kumencz/ROwen/PCB/render_2.png

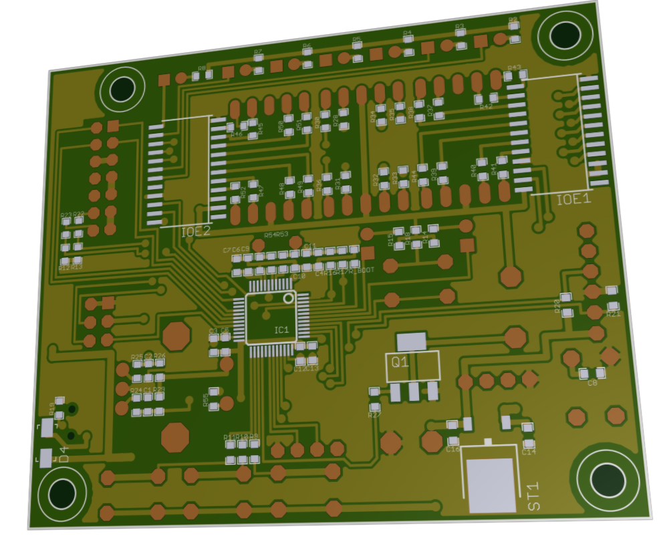
PCB/render_2.png
