kumencz/ROwen/README.md

# Reflow Owen
Reflow soldering heater project for FEKT VUT Brno
