kumencz/ROwen/PCB/render_1.png

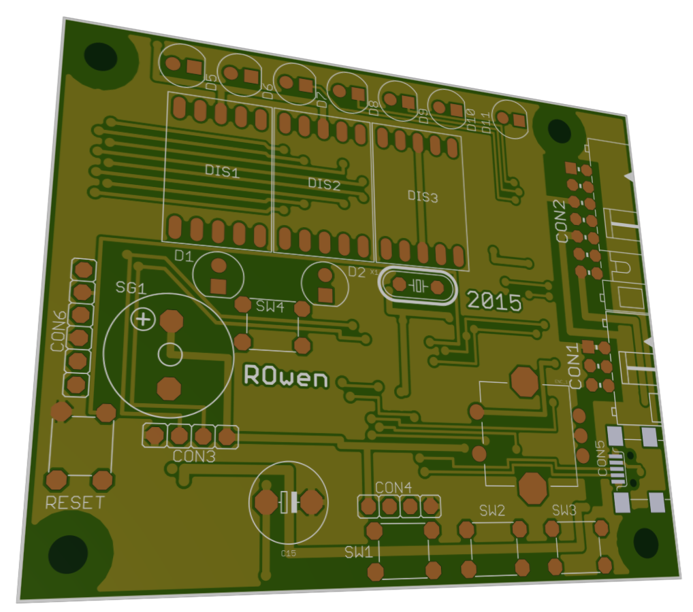
PCB/render_1.png
