kumencz/ROwen/Case/logic_board_case_rev1.stl

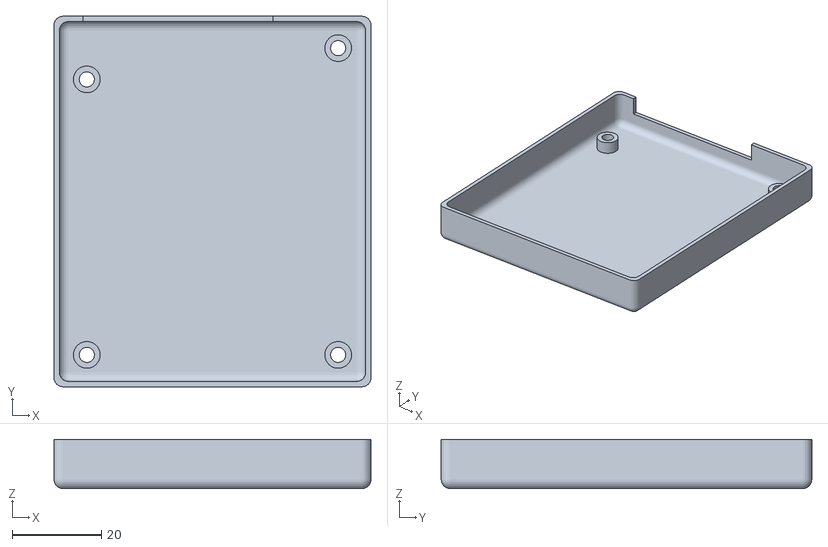
[picture p3: CAD file, 2020-12-23]
Case/logic_board_case_rev1.stl
71.0 x 83.0 x 11.0
