kumencz/ROwen/Case/logic_board_case_top_rev1.stl

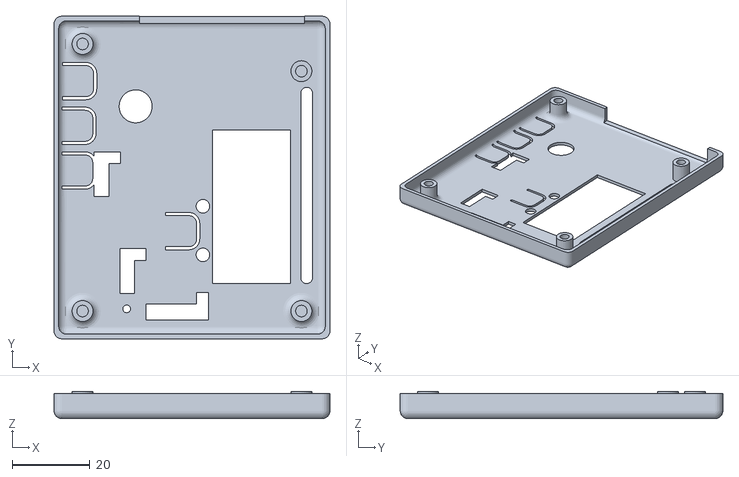
[picture p4: CAD file, 2020-12-23]
Case/logic_board_case_top_rev1.stl
71.0 x 83.0 x 7.00
