kumencz/ROwen/PCB/ROwen_main.brd

## EAGLE design PCB/ROwen_main.brd (2015-04-16)

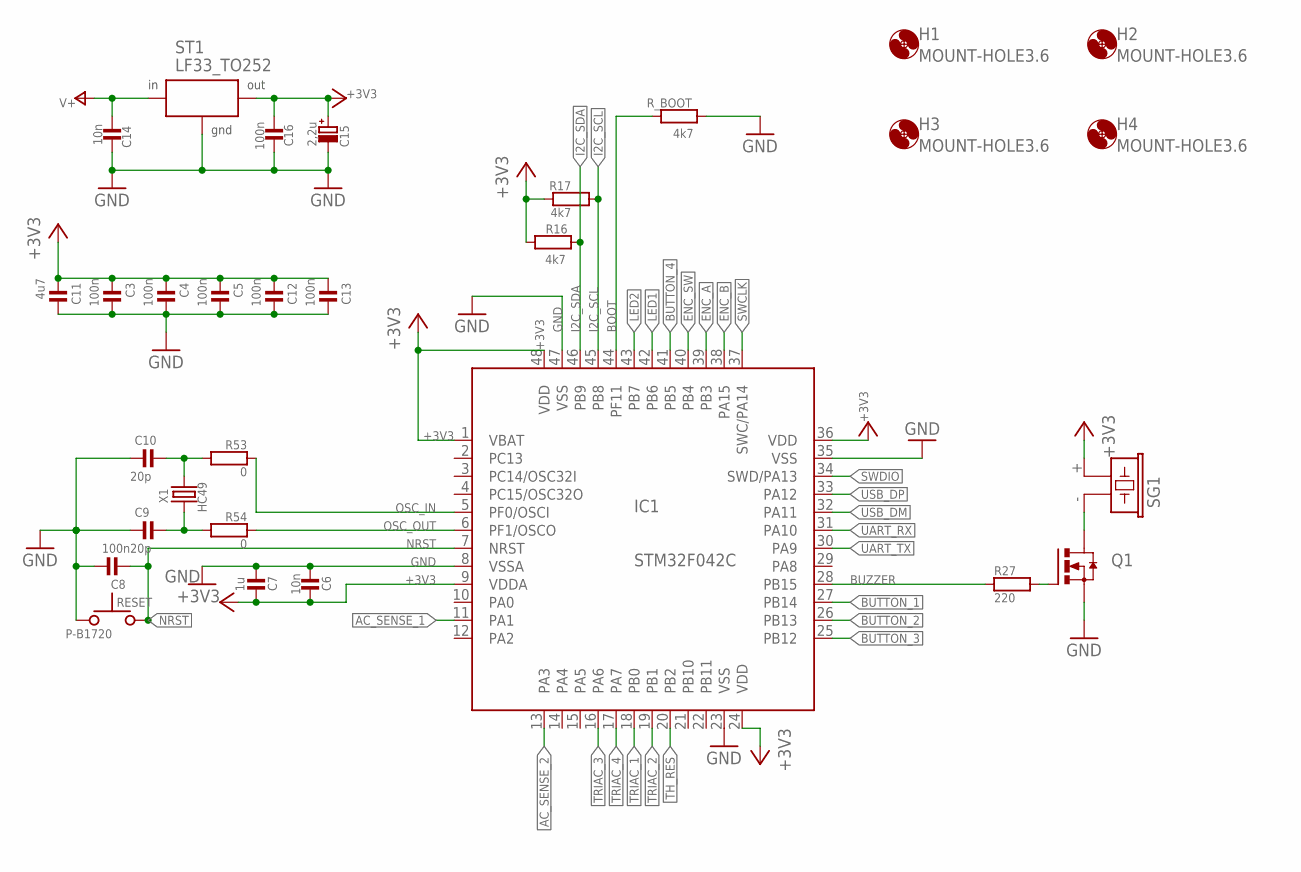
[picture p5: schematic ROwen_main.sch, sheet 1]

Parts:
C3, C4, C5, C8, C12, C13, C16: 100n; 0603
C6, C14: 10n; 0603
C7: 1u; 0603
C9, C10: 20p; 0603
C11: 4u7; 0603
C15: 2,2u; ER_08,5_05
H1, H2, H3, H4: MOUNT-HOLE3.6; 3,6
IC1: STM32F042C; LQFP48
Q1: N-HEXFET-2D_SOT232-IRLL014N; SOT223
R16, R17: 4k7; 0603
R27: 220; 0603
R53, R54: 0; 0603
RESET: P-B1720
R_BOOT: 4k7; 0603
SG1: F/CM12P
ST1: LF33_TO252; DPACK
X1: HC49; X_HC49/S

Connections:
+3V3: C3.2, C4.2, C5.2, C6.1, C7.1, C11.2, C12.2, C13.2, C15.+, C16.2, IC1.1 (VBAT), IC1.9 (VDDA), IC1.24 (VDD), IC1.36 (VDD), IC1.48 (VDD), R16.2, R17.2, SG1.+ (1), ST1.3 (OUT); also elsewhere on the board
AC_SENSE_1: IC1.11 (PA1); also elsewhere on the board
AC_SENSE_2: IC1.13 (PA3); also elsewhere on the board
BOOT: IC1.44 (PF11), R_BOOT.2
BUTTON_1: IC1.27 (PB14); also elsewhere on the board
BUTTON_2: IC1.26 (PB13); also elsewhere on the board
BUTTON_3: IC1.25 (PB12); also elsewhere on the board
BUTTON_4: IC1.41 (PB5); also elsewhere on the board
BUZZER: IC1.28 (PB15), R27.1
ENC_A: IC1.39 (PB3); also elsewhere on the board
ENC_B: IC1.38 (PA15); also elsewhere on the board
ENC_SW: IC1.40 (PB4); also elsewhere on the board
GND: C3.1, C4.1, C5.1, C6.2, C7.2, C8.1, C9.2, C10.2, C11.1, C12.1, C13.1, C14.2, C15.-, C16.1, IC1.8 (VSSA), IC1.23 (VSS), IC1.35 (VSS), IC1.47 (VSS), Q1.3 (S), RESET.1, R_BOOT.1, ST1.2 (GND); also elsewhere on the board
I2C_SCL: IC1.45 (PB8), R17.1; also elsewhere on the board
I2C_SDA: IC1.46 (PB9), R16.1; also elsewhere on the board
LED1: IC1.42 (PB6); also elsewhere on the board
LED2: IC1.43 (PB7); also elsewhere on the board
unnamed: Q1.2 (D), Q1.4 (D), SG1.- (2)
unnamed: Q1.1 (G), R27.2
unnamed: C9.1, R54.2, X1.1
unnamed: C10.1, R53.2, X1.2
NRST: C8.2, IC1.7 (NRST), RESET.2; also elsewhere on the board
OSC_IN: IC1.5 (PF0/OSCI), R53.1
OSC_OUT: IC1.6 (PF1/OSCO), R54.1
SWCLK: IC1.37 (SWC/PA14); also elsewhere on the board
SWDIO: IC1.34 (SWD/PA13); also elsewhere on the board
TH_RES: IC1.20 (PB2); also elsewhere on the board
TRIAC_1: IC1.18 (PB0); also elsewhere on the board
TRIAC_2: IC1.19 (PB1); also elsewhere on the board
TRIAC_3: IC1.16 (PA6); also elsewhere on the board
TRIAC_4: IC1.17 (PA7); also elsewhere on the board
UART_RX: IC1.31 (PA10); also elsewhere on the board
UART_TX: IC1.30 (PA9); also elsewhere on the board
USB_DM: IC1.32 (PA11); also elsewhere on the board
USB_DP: IC1.33 (PA12); also elsewhere on the board
V+: C14.1, ST1.1 (IN); also elsewhere on the board

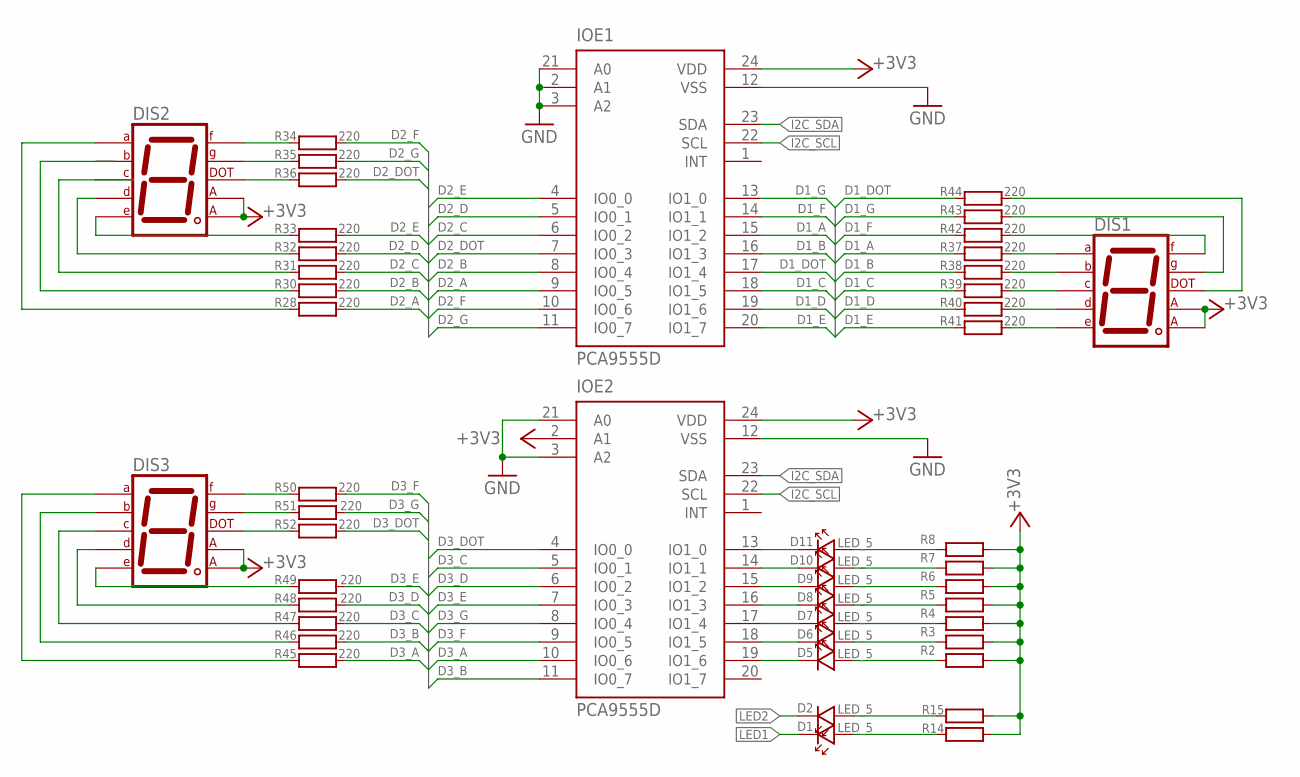
[picture p6: schematic ROwen_main.sch, sheet 2]

Parts:
D1, D2, D5, D6, D7, D8, D9, D10, D11: LED_5
DIS1, DIS2, DIS3: 7-SEGMENT-CA-0.56"; 7_SEGMENT_0.56"
IOE1, IOE2: PCA9555D; SO24
R2, R3, R4, R5, R6, R7, R8, R14, R15: R_R0603; 0603
R28, R30, R31, R32, R33, R34, R35, R36, R37, R38, R39, R40, R41, R42, R43, R44, R45, R46, R47, R48, R49, R50, R51, R52: 220; 0603

Connections:
+3V3: DIS1.3 (CA2), DIS1.8 (CA1), DIS2.3 (CA2), DIS2.8 (CA1), DIS3.3 (CA2), DIS3.8 (CA1), IOE1.24 (VDD), IOE2.2 (A1), IOE2.24 (VDD), R2.2, R3.2, R4.2, R5.2, R6.2, R7.2, R8.2, R14.2, R15.2; also elsewhere on the board
D1_A: IOE1.15 (IO1_2), R37.2
D1_B: IOE1.16 (IO1_3), R38.2
D1_C: IOE1.18 (IO1_5), R39.2
D1_D: IOE1.19 (IO1_6), R40.2
D1_DOT: IOE1.17 (IO1_4), R44.2
D1_E: IOE1.20 (IO1_7), R41.2
D1_F: IOE1.14 (IO1_1), R42.2
D1_G: IOE1.13 (IO1_0), R43.2
D2_A: IOE1.9 (IO0_5), R28.2
D2_B: IOE1.8 (IO0_4), R30.2
D2_C: IOE1.6 (IO0_2), R31.2
D2_D: IOE1.5 (IO0_1), R32.2
D2_DOT: IOE1.7 (IO0_3), R36.2
D2_E: IOE1.4 (IO0_0), R33.2
D2_F: IOE1.10 (IO0_6), R34.2
D2_G: IOE1.11 (IO0_7), R35.2
D3_A: IOE2.10 (IO0_6), R45.2
D3_B: IOE2.11 (IO0_7), R46.2
D3_C: IOE2.5 (IO0_1), R47.2
D3_D: IOE2.6 (IO0_2), R48.2
D3_DOT: IOE2.4 (IO0_0), R52.2
D3_E: IOE2.7 (IO0_3), R49.2
D3_F: IOE2.9 (IO0_5), R50.2
D3_G: IOE2.8 (IO0_4), R51.2
GND: IOE1.2 (A1), IOE1.3 (A2), IOE1.12 (VSS), IOE1.21 (A0), IOE2.3 (A2), IOE2.12 (VSS), IOE2.21 (A0); also elsewhere on the board
I2C_SCL: IOE1.22 (SCL), IOE2.22 (SCL); also elsewhere on the board
I2C_SDA: IOE1.23 (SDA), IOE2.23 (SDA); also elsewhere on the board
LED1: D1.K; also elsewhere on the board
LED2: D2.K; also elsewhere on the board
unnamed: DIS1.7 (A), R37.1
unnamed: DIS1.6 (B), R38.1
unnamed: DIS1.4 (C), R39.1
unnamed: DIS1.2 (D), R40.1
unnamed: DIS1.1 (E), R41.1
unnamed: DIS1.9 (F), R42.1
unnamed: DIS2.7 (A), R28.1
unnamed: DIS2.6 (B), R30.1
unnamed: DIS2.4 (C), R31.1
unnamed: DIS2.2 (D), R32.1
unnamed: DIS2.1 (E), R33.1
unnamed: DIS2.9 (F), R34.1
unnamed: DIS2.10 (G), R35.1
unnamed: DIS3.7 (A), R45.1
unnamed: DIS3.6 (B), R46.1
unnamed: DIS3.4 (C), R47.1
unnamed: DIS3.2 (D), R48.1
unnamed: DIS3.1 (E), R49.1
unnamed: DIS3.9 (F), R50.1
unnamed: DIS3.10 (G), R51.1
unnamed: DIS3.5 (DP), R52.1
unnamed: D11.A, R8.1
unnamed: D10.A, R7.1
unnamed: D8.A, R5.1
unnamed: D6.A, R3.1
unnamed: D5.A, R2.1
unnamed: D7.A, R4.1
unnamed: D9.A, R6.1
unnamed: D5.K, IOE2.19 (IO1_6)
unnamed: D6.K, IOE2.18 (IO1_5)
unnamed: D7.K, IOE2.17 (IO1_4)
unnamed: D8.K, IOE2.16 (IO1_3)
unnamed: D9.K, IOE2.15 (IO1_2)
unnamed: D10.K, IOE2.14 (IO1_1)
unnamed: D11.K, IOE2.13 (IO1_0)
unnamed: D2.A, R15.1
unnamed: D1.A, R14.1
unnamed: DIS1.10 (G), R43.1
unnamed: DIS1.5 (DP), R44.1
unnamed: DIS2.5 (DP), R36.1

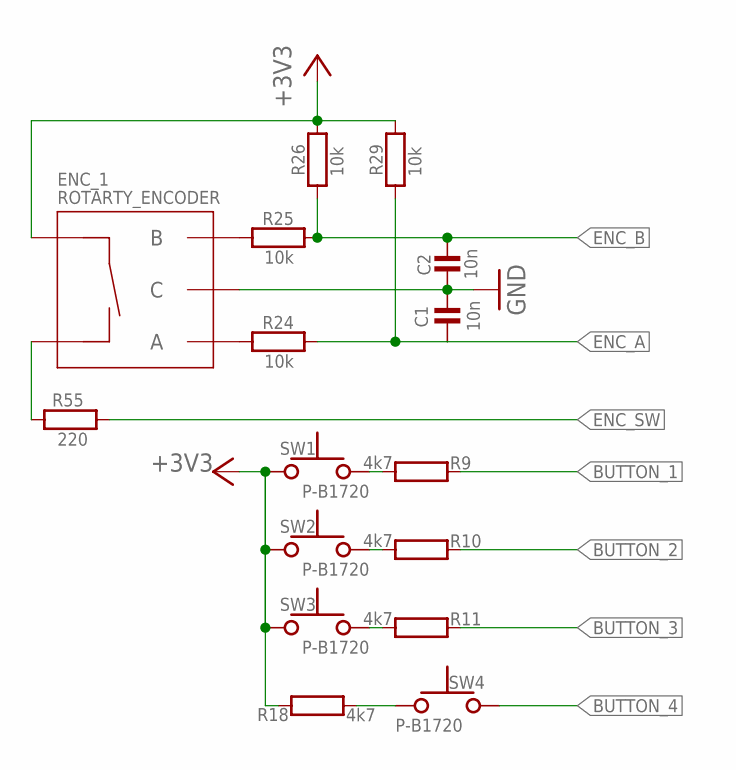
[picture p7: schematic ROwen_main.sch, sheet 3]

Parts:
C1, C2: 10n; 0603
ENC_1: ROTARTY_ENCODER; ROTARY_ENC_PLAIN
R9, R10, R11, R18: 4k7; 0603
R24, R25, R26, R29: 10k; 0603
R55: 220; 0603
SW1, SW2, SW3, SW4: P-B1720

Connections:
+3V3: ENC_1.SW+, R18.1, R26.1, R29.1, SW1.1, SW2.1, SW3.1; also elsewhere on the board
BUTTON_1: R9.1; also elsewhere on the board
BUTTON_2: R10.1; also elsewhere on the board
BUTTON_3: R11.1; also elsewhere on the board
BUTTON_4: SW4.1; also elsewhere on the board
ENC_A: C1.2, R24.1, R29.2; also elsewhere on the board
ENC_B: C2.1, R25.1, R26.2; also elsewhere on the board
ENC_SW: R55.2; also elsewhere on the board
GND: C1.1, C2.2, ENC_1.C; also elsewhere on the board
unnamed: R9.2, SW1.2
unnamed: R10.2, SW2.2
unnamed: R11.2, SW3.2
unnamed: R18.2, SW4.2
unnamed: ENC_1.B, R25.2
unnamed: ENC_1.A, R24.2
unnamed: ENC_1.SW-, R55.1

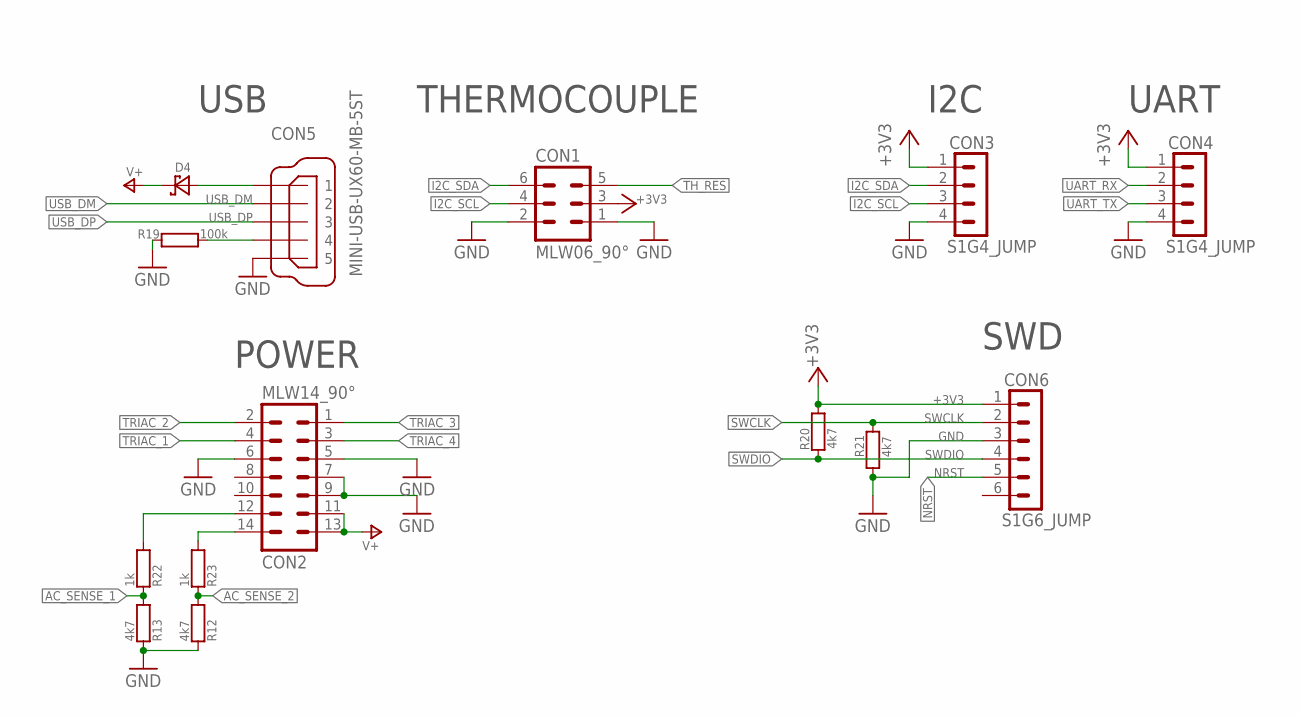
[picture p8: schematic ROwen_main.sch, sheet 4]

Parts:
CON1: MLW06_90°; MLW06A
CON2: MLW14_90°; MLW14A
CON3, CON4: S1G4_JUMP; S1G4_JUM
CON5: MINI-USB-UX60-MB-5ST; UX60-MB-5ST
CON6: S1G6_JUMP; S1G6_JUM
D4: D_SCHOTKY_SMA; D_SMA
R12, R13, R20, R21: 4k7; 0603
R19: 100k; 0603
R22, R23: 1k; 0603

Connections:
+3V3: CON1.3, CON3.1, CON4.1, CON6.1, R20.2; also elsewhere on the board
AC_SENSE_1: R13.2, R22.1; also elsewhere on the board
AC_SENSE_2: R12.2, R23.1; also elsewhere on the board
GND: CON1.1, CON1.2, CON2.5, CON2.6, CON2.7, CON2.9, CON3.4, CON4.4, CON5.5, CON6.3, R12.1, R13.1, R19.1, R21.1; also elsewhere on the board
I2C_SCL: CON1.4, CON3.3; also elsewhere on the board
I2C_SDA: CON1.6, CON3.2; also elsewhere on the board
unnamed: CON5.1, D4.A
unnamed: CON5.4, R19.2
NRST: CON6.5; also elsewhere on the board
SINUS_A: CON2.12, R22.2
SINUS_B: CON2.14, R23.2
SWCLK: CON6.2, R21.2; also elsewhere on the board
SWDIO: CON6.4, R20.1; also elsewhere on the board
TH_RES: CON1.5; also elsewhere on the board
TRIAC_1: CON2.4; also elsewhere on the board
TRIAC_2: CON2.2; also elsewhere on the board
TRIAC_3: CON2.1; also elsewhere on the board
TRIAC_4: CON2.3; also elsewhere on the board
UART_RX: CON4.2; also elsewhere on the board
UART_TX: CON4.3; also elsewhere on the board
USB_DM: CON5.2; also elsewhere on the board
USB_DP: CON5.3; also elsewhere on the board
V+: CON2.11, CON2.13, D4.K; also elsewhere on the board

Notes on the sheet:
I2C
UART
SWD
THERMOCOUPLE
POWER
USB

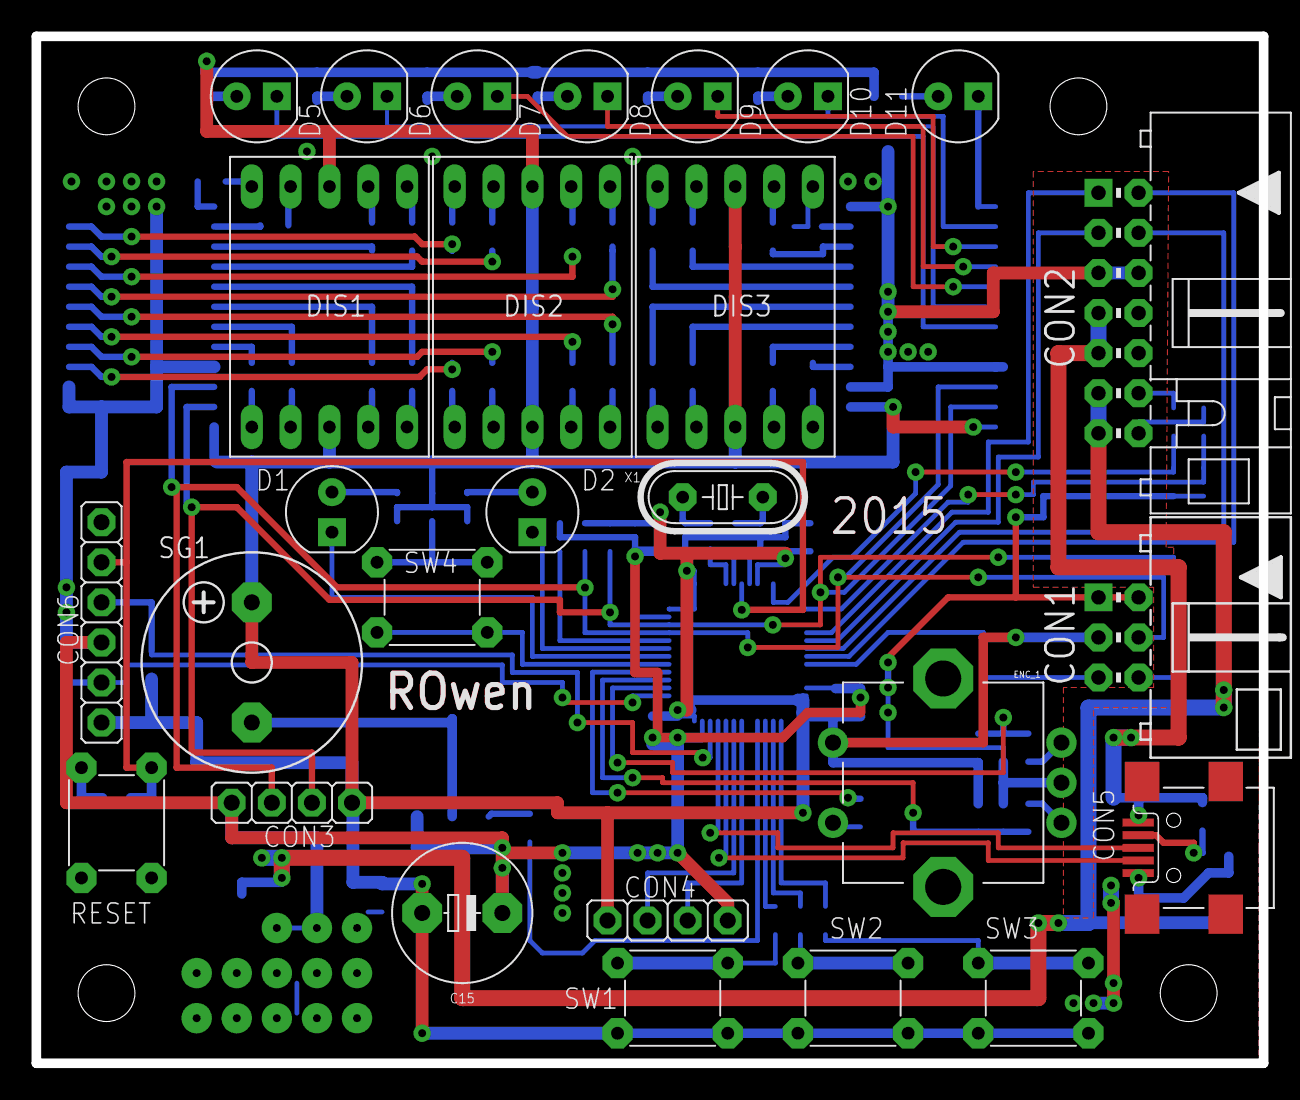
[picture p9: board ROwen_main.brd from above]

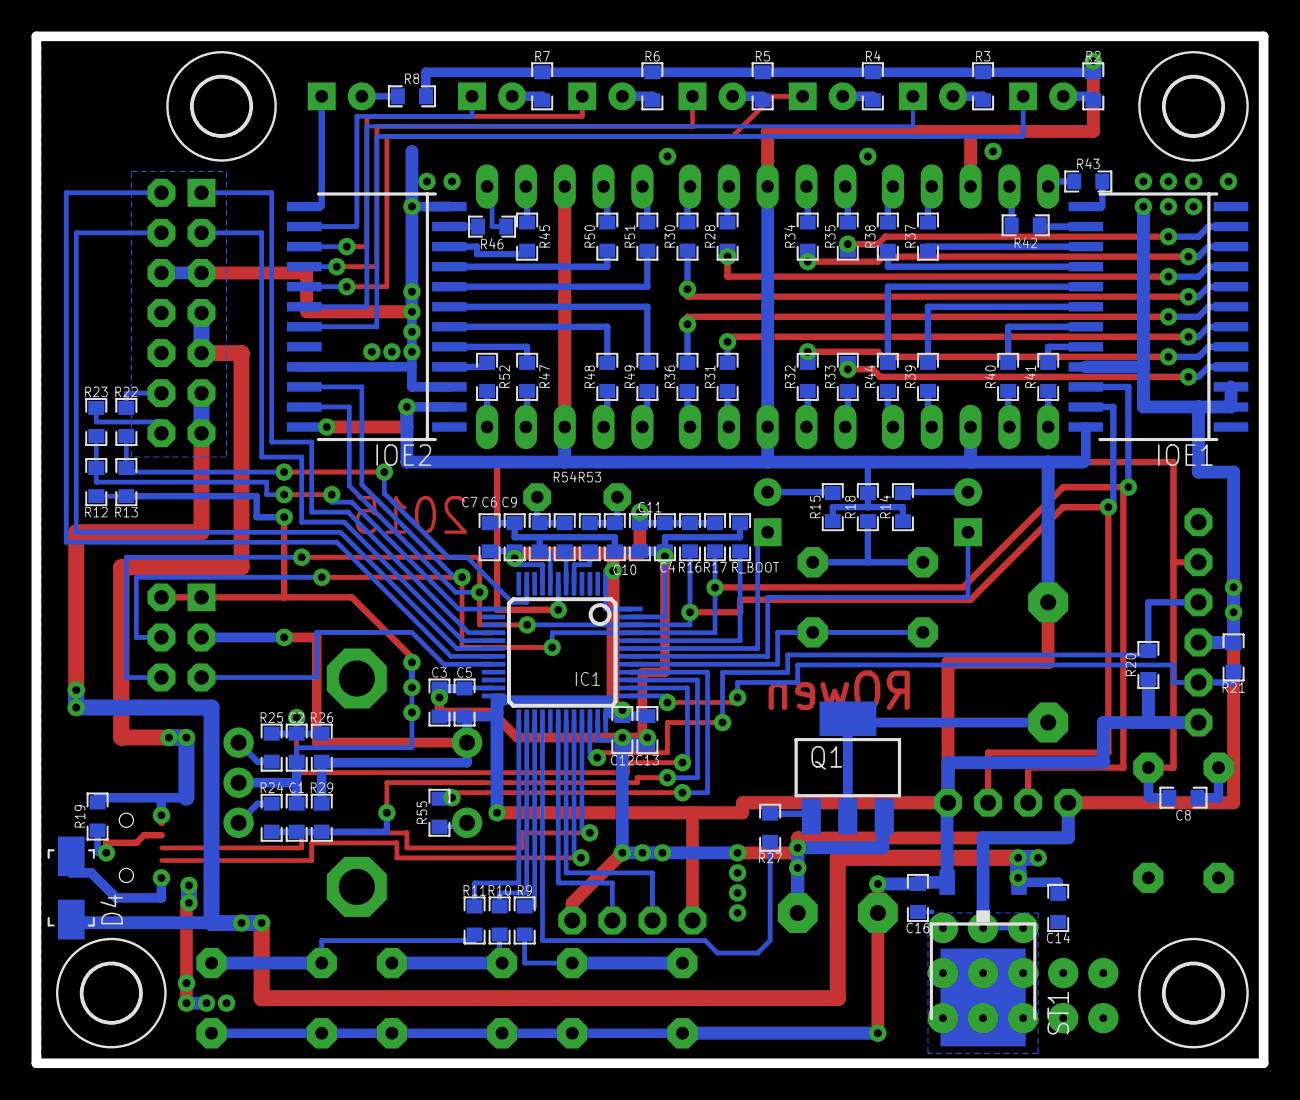
[picture p10: board ROwen_main.brd from below]

Board: 2 copper layers, 77.8 x 65.1 mm, 107 parts (80 on the bottom side), 111 nets.
