kumencz/ROwen/PCB/ROwen_Power.brd

## EAGLE design PCB/ROwen_Power.brd (2015-04-16)

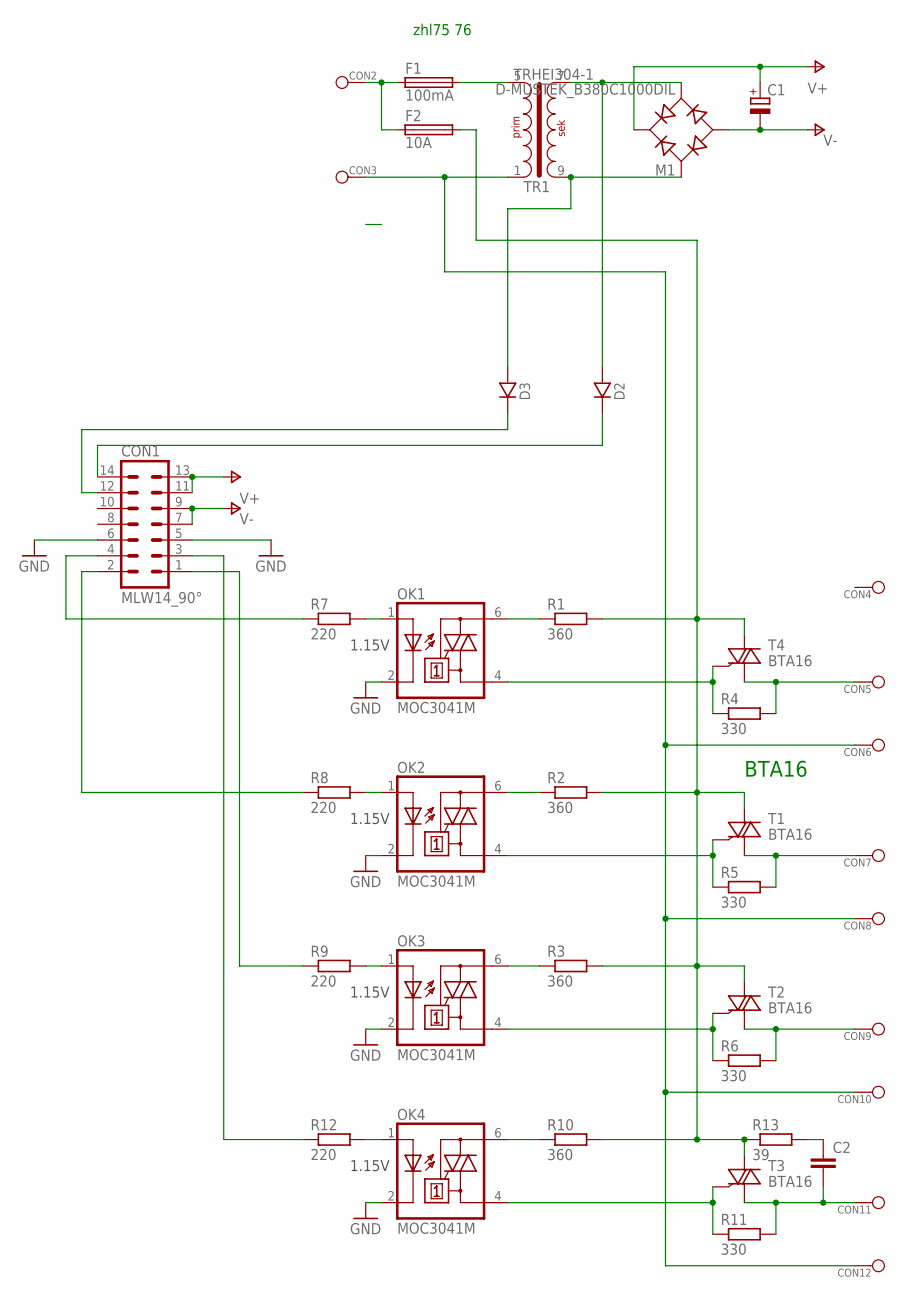
[picture p11: schematic ROwen_Power.sch]

Parts:
C1: CPOL-EUE3.5-10; E3,5-10
C2: C-EU050-055X075; C050-055X075
CON1: MLW14_90°; MLW14A
CON2, CON3, CON4, CON5, CON6, CON7, CON8, CON9, CON10, CON11, CON12: WAGO256
D2, D3: D_10; DO41
F1: 100mA; SH22,5A
F2: 10A; SH22,5A
M1: D-MUSTEK_B380C1000DIL; DM_DB1
OK1, OK2, OK3, OK4: MOC3041M; DIL06
R1, R2, R3, R10: 360; 0207/10
R4, R5, R6, R11: 330; 0207/10
R7, R8, R9, R12: 220; 0207/10
R13: 39; 0309/12
T1, T2, T3, T4: BTA16; TO220
TR1: TRHEI304-1; TRHEI304

Connections:
GND: CON1.5, CON1.6, OK1.2 (C), OK2.2 (C), OK3.2 (C), OK4.2 (C)
unnamed: CON1.1, R9.1
unnamed: OK1.6 (A2), R1.1
unnamed: CON5.1, R4.2, T4.T1 (A1)
unnamed: OK3.4 (A1), R6.1, T2.G
unnamed: OK2.4 (A1), R5.1, T1.G
unnamed: OK3.1 (A), R9.2
unnamed: OK3.6 (A2), R3.1
unnamed: CON7.1, R5.2, T1.T1 (A1)
unnamed: OK1.4 (A1), R4.1, T4.G
unnamed: CON1.4, R7.1
unnamed: OK2.6 (A2), R2.1
unnamed: CON9.1, R6.2, T2.T1 (A1)
unnamed: F1.2, TR1.5 (P2)
unnamed: OK2.1 (A), R8.2
unnamed: OK1.1 (A), R7.2
unnamed: CON2.1, F1.1, F2.1
unnamed: F2.2, R1.2, R2.2, R3.2, R10.2, R13.1, T1.T2 (A2), T2.T2 (A2), T3.T2 (A2), T4.T2 (A2)
unnamed: D3.A, M1.AC1, TR1.9 (S2)
unnamed: CON3.1, CON6.1, CON8.1, CON10.1, CON12.1, TR1.1
unnamed: D2.A, M1.AC2, TR1.7 (S1)
unnamed: CON1.2, R8.1
unnamed: C2.1, R13.2
unnamed: C2.2, CON11.1, R11.2, T3.T1 (A1)
unnamed: OK4.4 (A1), R11.1, T3.G
unnamed: CON1.14, D2.K
unnamed: CON1.12, D3.K
unnamed: OK4.6 (A2), R10.1
unnamed: OK4.1 (A), R12.2
unnamed: CON1.3, R12.1
V+: C1.+, CON1.11, CON1.13, M1.+
V-: C1.-, CON1.7, CON1.9, M1.-

Notes on the sheet:
BTA16
1.15V
zhl75 76

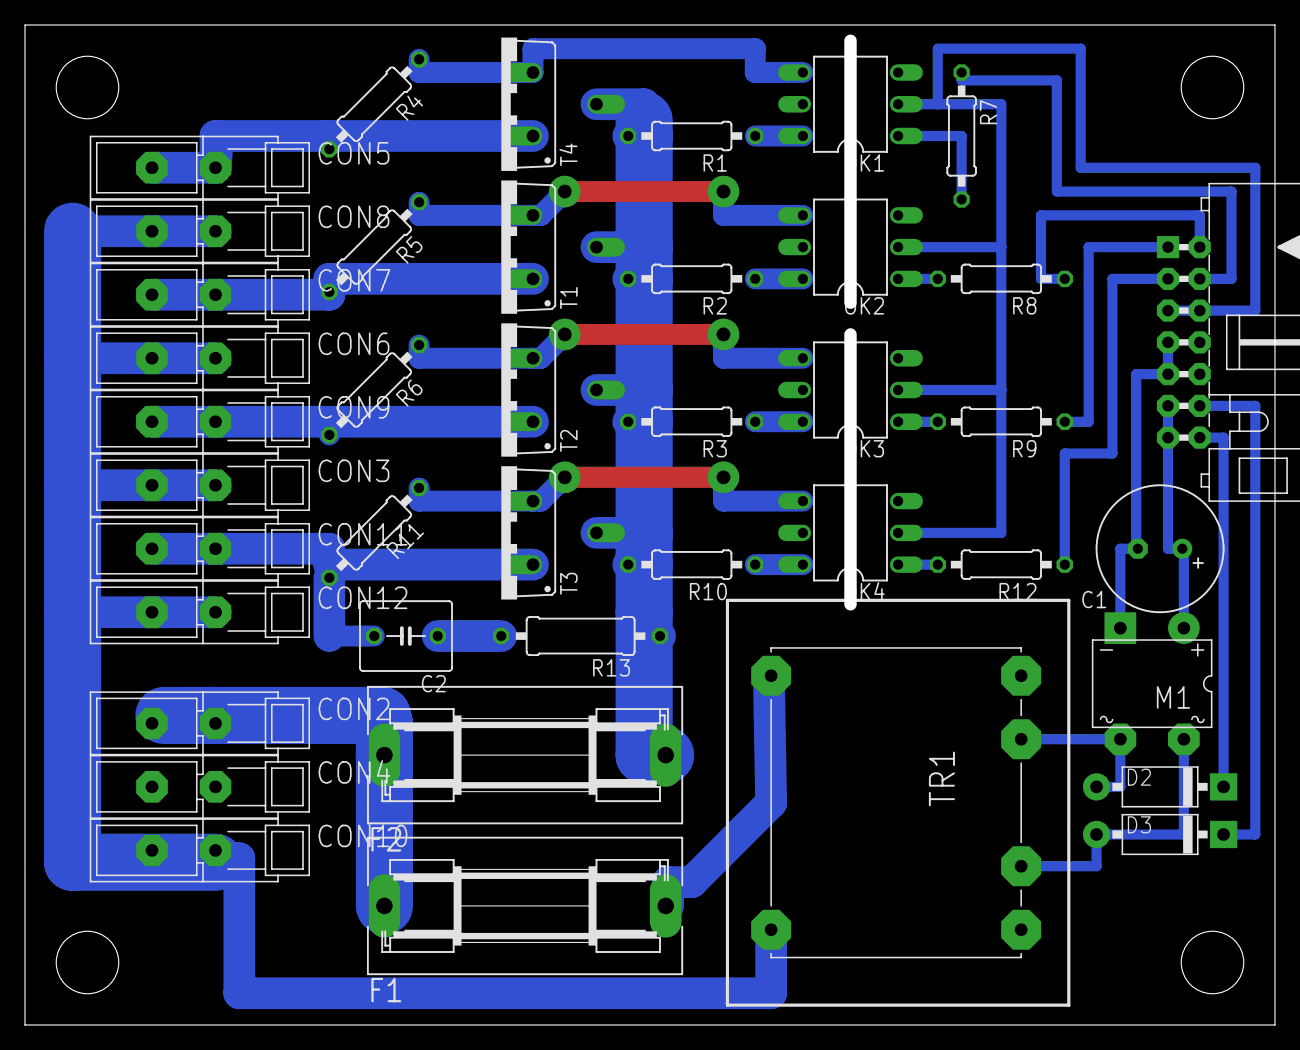
[picture p12: board ROwen_Power.brd from above]

Board: 2 copper layers, 100.0 x 80.0 mm, 41 parts (0 on the bottom side), 32 nets.
