kumencz/ROwen/PCB/ROwen_thermocouple.brd

## EAGLE design PCB/ROwen_thermocouple.brd (2015-04-14)

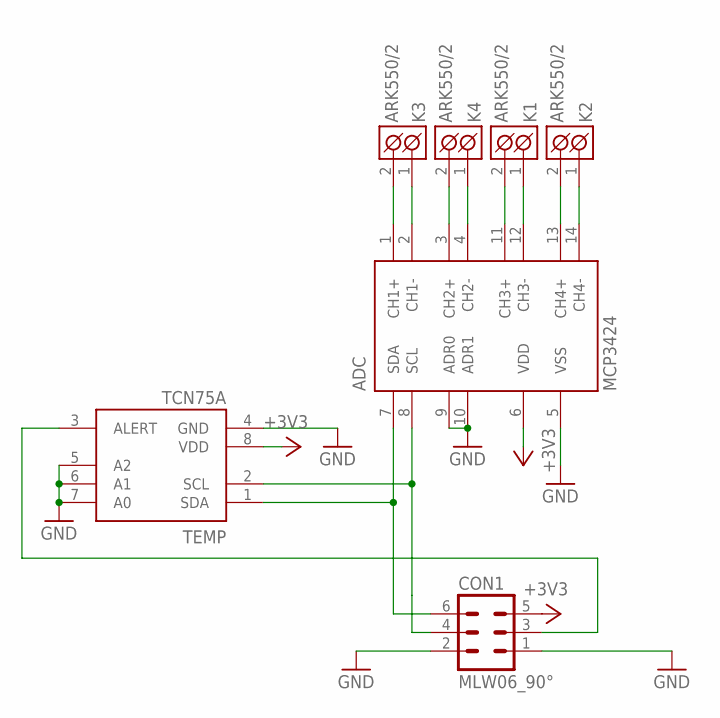
[picture p13: schematic ROwen_thermocouple.sch]

Parts:
ADC: MCP3424; TSSOP14
CON1: MLW06_90°; MLW06A
K1, K2, K3, K4: ARK550/2
TEMP: TCN75A; SO8

Connections:
+3V3: ADC.6 (VDD), CON1.5, TEMP.8 (VDD)
GND: ADC.5 (VSS), ADC.9 (ADR0), ADC.10 (ADR1), CON1.1, CON1.2, TEMP.4 (GND), TEMP.5 (A2), TEMP.6 (A1), TEMP.7 (A0)
unnamed: ADC.12 (CH3-), K1.1 (K1)
unnamed: ADC.11 (CH3+), K1.2 (K2)
unnamed: ADC.14 (CH4-), K2.1 (K1)
unnamed: ADC.13 (CH4+), K2.2 (K2)
unnamed: ADC.2 (CH1-), K3.1 (K1)
unnamed: ADC.1 (CH1+), K3.2 (K2)
unnamed: ADC.4 (CH2-), K4.1 (K1)
unnamed: ADC.3 (CH2+), K4.2 (K2)
unnamed: CON1.3, TEMP.3 (ALERT)
unnamed: ADC.8 (SCL), CON1.4, TEMP.2 (SCL)
unnamed: ADC.7 (SDA), CON1.6, TEMP.1 (SDA)

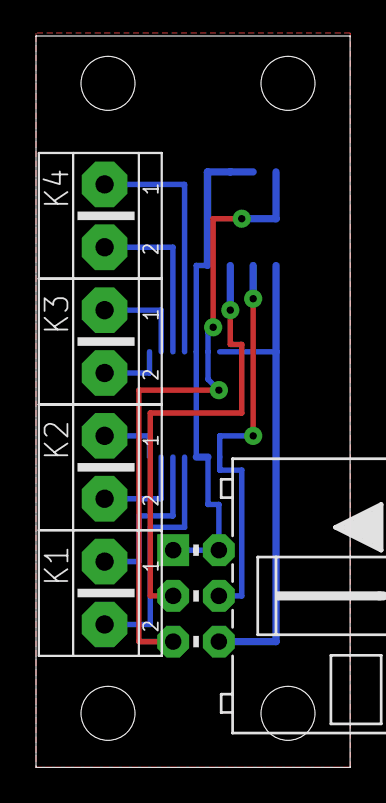
[picture p14: board ROwen_thermocouple.brd from above]

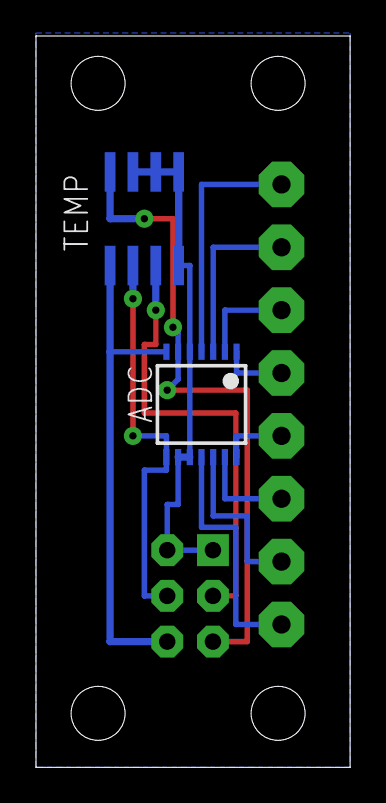
[picture p15: board ROwen_thermocouple.brd from below]

Board: 2 copper layers, 17.4 x 40.6 mm, 7 parts (2 on the bottom side), 13 nets.
