kumencz/ROwen/FW/Source/ROwen/main.c

/* Includes ------------------------------------------------------------------*/
#include "main.h"
/* Private typedef -----------------------------------------------------------*/
/* Private define ------------------------------------------------------------*/
/* Private macro -------------------------------------------------------------*/
/* Private variables ---------------------------------------------------------*/
/* Private function prototypes -----------------------------------------------*/
/* Private functions ---------------------------------------------------------*/

/**
  * @brief  Main program.
  * @param  None
  * @retval None
  */
int main(void)
{
	SystemCoreClockUpdate();
	initialization();

	/* Infinite loop */
	while (1)
	{
		period_time_check_flags();
		speed_counter++;
	}
}
