kumencz/ROwen/FW/ROwen.ioc

Mcu.UserName=STM32F051C8Tx
PA1.GPIO_Label=AC_SENSE_1
PA1.Signal=COMP1_INP
PA10.Signal=USART1_RX
PA13.Signal=SYS_SWDIO
PA14.Signal=SYS_SWCLK
PA15.GPIO_Label=ENC_A
PA15.Signal=GPXTI15
PA3.GPIO_Label=AC_SENSE_2
PA3.Signal=COMP2_INP
PA6.GPIO_Label=TRIAC_3
PA6.Signal=S_TIM3_CH1
PA7.GPIO_Label=TRIAC_4
PA7.Signal=S_TIM3_CH2
PA9.Signal=USART1_TX
PB0.GPIO_Label=TRIAC_1
PB0.Signal=S_TIM3_CH3
PB1.GPIO_Label=TRIAC_2
PB1.Signal=S_TIM3_CH4
PB12.GPIO_Label=BUTTON_3
PB12.Signal=GPXTI12
PB13.GPIO_Label=BUTTON_2
PB13.Signal=GPXTI13
PB14.GPIO_Label=BUTTON_1
PB14.Signal=GPXTI14
PB15.GPIO_Label=BUZZER
PB15.Signal=GPIO_Output
PB2.GPIO_Label=TH_RES
PB2.Signal=GPIO_Input
PB3.GPIO_Label=ENC_B
PB3.Signal=GPIO_Input
PB4.GPIO_Label=ENC_SW
PB4.Signal=GPXTI4
PB5.GPIO_Label=BUTTON_4
PB5.Signal=GPXTI5
PB6.GPIO_Label=LED_1
PB6.Signal=GPIO_Output
PB7.GPIO_Label=LED_2
PB7.Signal=GPIO_Output
PB8.Signal=I2C1_SCL
PB9.Signal=I2C1_SDA
PF0-OSC_IN.Signal=RCC_OSC_IN
PF1-OSC_OUT.Signal=RCC_OSC_OUT
