kumencz/ROwen/FW/Source/ROwen/init.c

/* Includes ------------------------------------------------------------------*/
#include "main.h"
/* Private typedef -----------------------------------------------------------*/
/* Private define ------------------------------------------------------------*/



/* Private macro -------------------------------------------------------------*/
/* Private variables ---------------------------------------------------------*/
/* Private function prototypes -----------------------------------------------*/
/* Private functions ---------------------------------------------------------*/
/* Private macro -------------------------------------------------------------*/
/* Private variables ---------------------------------------------------------*/

void init_SysTick(void);
void init_Board_HMI(void);
void init_ADC(void);
void init_USART(void);
void init_I2C(void);
void init_Flash(void);
void init_I2C(void);
void init_ADC(void);
void init_USART(void);
void init_Triacs(void);

void initialization(void)
{
	init_SysTick();
	init_I2C();
	init_Board_HMI();
	init_ADC();
	init_USART();
	init_Triacs();
//	init_Flash();

	mode_selector(next_action);
}
void init_SysTick(void)
{
	if (SysTick_Config(SystemCoreClock / 1000))
	{ 
		/* Capture error */ 
		while (1);
	}
}
void init_I2C(void)
{
	GPIO_InitTypeDef GPIO_InitStructure;
	I2C_InitTypeDef  I2C_InitStructure;
	NVIC_InitTypeDef NVIC_InitStructure;
	
	/* Enable the I2C periph */
	RCC_APB1PeriphClockCmd(RCC_APB1Periph_I2C1, ENABLE);
	/* Enable SCK and SDA GPIO clocks */
	RCC_AHBPeriphClockCmd(RCC_AHBPeriph_GPIOB , ENABLE);

	/* Set GPIO pins */
	GPIO_PinAFConfig(GPIOB, GPIO_PinSource8, GPIO_AF_1);
	GPIO_PinAFConfig(GPIOB, GPIO_PinSource9, GPIO_AF_1);
	/* I2C SDA and SCL pins configuration */
	GPIO_InitStructure.GPIO_Pin = GPIO_Pin_8 | GPIO_Pin_9;
	GPIO_InitStructure.GPIO_Mode = GPIO_Mode_AF;
	GPIO_InitStructure.GPIO_Speed = GPIO_Speed_2MHz;
	GPIO_InitStructure.GPIO_OType = GPIO_OType_OD;
	GPIO_InitStructure.GPIO_PuPd  = GPIO_PuPd_NOPULL;
	GPIO_Init(GPIOB, &GPIO_InitStructure);
	
	/* I2C configuration -------------------------------------------------------*/
	I2C_InitStructure.I2C_Mode = I2C_Mode_I2C;
	I2C_InitStructure.I2C_AnalogFilter = I2C_AnalogFilter_Enable;
	I2C_InitStructure.I2C_DigitalFilter = 0x00;
	I2C_InitStructure.I2C_OwnAddress1 = 0x00;
	I2C_InitStructure.I2C_Ack = I2C_Ack_Enable;
	I2C_InitStructure.I2C_AcknowledgedAddress = I2C_AcknowledgedAddress_7bit;
	//I2C_InitStructure.I2C_Timing = 0x00902025;
	I2C_InitStructure.I2C_Timing =   0x2000090E;

	/* Apply LSM303DLHC_I2C configuration after enabling it */
	I2C_Init(I2C1, &I2C_InitStructure);

	/* LSM303DLHC_I2C Peripheral Enable */
	I2C_Cmd(I2C1, ENABLE);

	I2C_ITConfig(I2C1, I2C_IT_TCI, ENABLE);
	I2C_ITConfig(I2C1, I2C_IT_ERRI, ENABLE);
	I2C_ITConfig(I2C1, I2C_IT_STOPI, ENABLE);
	I2C_ITConfig(I2C1, I2C_IT_NACKI, ENABLE);
	I2C_ITConfig(I2C1, I2C_IT_ADDRI, ENABLE);
	I2C_ITConfig(I2C1, I2C_IT_RXI, ENABLE);
	I2C_ITConfig(I2C1, I2C_IT_TXI, ENABLE);

	/* Configure the I2C1 interrupt priority */
	NVIC_InitStructure.NVIC_IRQChannel = I2C1_IRQn;
	NVIC_InitStructure.NVIC_IRQChannelPriority=1;
	NVIC_InitStructure.NVIC_IRQChannelCmd = ENABLE;
	NVIC_Init(&NVIC_InitStructure);

	/* Prepare i2c sessions to use */
	Define_I2C_Sessions();
}


void init_Board_HMI(void)
{
	GPIO_InitTypeDef GPIO_InitStructure;
	EXTI_InitTypeDef EXTI_InitStructure;
	NVIC_InitTypeDef NVIC_InitStructure;

	/* Enable Clocks */
	RCC_AHBPeriphClockCmd(RCC_AHBPeriph_GPIOB, ENABLE);
	RCC_AHBPeriphClockCmd(RCC_AHBPeriph_GPIOA, ENABLE);
	RCC_APB2PeriphClockCmd(RCC_APB2Periph_SYSCFG, ENABLE);

	/* =========== Init 2 LEDs =========== */
	/* set all LEDs to Off */
	GPIO_SetBits(GPIOB,GPIO_Pin_6 | GPIO_Pin_7);
	/* Configure pins */
	GPIO_InitStructure.GPIO_Pin =  GPIO_Pin_6 | GPIO_Pin_7;
	GPIO_InitStructure.GPIO_Mode = GPIO_Mode_OUT;
	GPIO_InitStructure.GPIO_OType = GPIO_OType_PP;
	GPIO_InitStructure.GPIO_PuPd = GPIO_PuPd_UP;
	GPIO_InitStructure.GPIO_Speed = GPIO_Speed_50MHz;
	GPIO_Init(GPIOB, &GPIO_InitStructure);

	/* =========== Init Buzzer =========== */
	/* set buzzer to off */
	GPIO_SetBits(GPIOB,GPIO_Pin_15);
	/* Configure pins */
	GPIO_InitStructure.GPIO_Pin =  GPIO_Pin_15;
	GPIO_InitStructure.GPIO_Mode = GPIO_Mode_OUT;
	GPIO_InitStructure.GPIO_OType = GPIO_OType_PP;
	GPIO_InitStructure.GPIO_PuPd = GPIO_PuPd_UP;
	GPIO_InitStructure.GPIO_Speed = GPIO_Speed_50MHz;
	GPIO_Init(GPIOB, &GPIO_InitStructure);

	/* =========== Init Buttons =========== */
	/* Configure Buttons pins as input */
	GPIO_InitStructure.GPIO_Pin = GPIO_Pin_5 | GPIO_Pin_12 | GPIO_Pin_13 | GPIO_Pin_14;
	GPIO_InitStructure.GPIO_Mode = GPIO_Mode_IN;
	GPIO_InitStructure.GPIO_OType = GPIO_OType_PP;
	GPIO_InitStructure.GPIO_PuPd = GPIO_PuPd_DOWN;
	GPIO_InitStructure.GPIO_Speed = GPIO_Speed_50MHz;
	GPIO_Init(GPIOB, &GPIO_InitStructure);

	/* Connect Buttons EXTI Lines to Buttons GPIO Pins */
	SYSCFG_EXTILineConfig(EXTI_PortSourceGPIOB, EXTI_PinSource5);
	SYSCFG_EXTILineConfig(EXTI_PortSourceGPIOB, EXTI_PinSource12);
	SYSCFG_EXTILineConfig(EXTI_PortSourceGPIOB, EXTI_PinSource13);
	SYSCFG_EXTILineConfig(EXTI_PortSourceGPIOB, EXTI_PinSource14);

	/* Configure Buttons EXTI line */
	EXTI_InitStructure.EXTI_Line = EXTI_Line4 | EXTI_Line5 | EXTI_Line12 | EXTI_Line13 | EXTI_Line14;
	EXTI_InitStructure.EXTI_Mode = EXTI_Mode_Interrupt;
	EXTI_InitStructure.EXTI_Trigger = EXTI_Trigger_Rising;  
	EXTI_InitStructure.EXTI_LineCmd = ENABLE;
	EXTI_Init(&EXTI_InitStructure);

	/* =========== Init GPIO pins outputing on power board =========== */ // previously AC_sense pins
	/* Configure pins as output */
	GPIO_InitStructure.GPIO_Pin =  GPIO_Pin_1 | GPIO_Pin_3;
	GPIO_InitStructure.GPIO_Mode = GPIO_Mode_OUT;
	GPIO_InitStructure.GPIO_OType = GPIO_OType_PP;
	GPIO_InitStructure.GPIO_PuPd = GPIO_PuPd_NOPULL;
	GPIO_InitStructure.GPIO_Speed = GPIO_Speed_50MHz;
	GPIO_Init(GPIOA, &GPIO_InitStructure);

	/* =========== Init Encoder =========== */
	/* Configure Encoder pins as input */	
	GPIO_InitStructure.GPIO_Pin = GPIO_Pin_3;
	GPIO_InitStructure.GPIO_Mode = GPIO_Mode_IN;
	GPIO_InitStructure.GPIO_OType = GPIO_OType_PP;
	GPIO_InitStructure.GPIO_PuPd = GPIO_PuPd_DOWN;
	GPIO_InitStructure.GPIO_Speed = GPIO_Speed_50MHz;
	GPIO_Init(GPIOB, &GPIO_InitStructure);

	GPIO_InitStructure.GPIO_Pin = GPIO_Pin_15;
	GPIO_Init(GPIOA, &GPIO_InitStructure);

	GPIO_InitStructure.GPIO_PuPd = GPIO_PuPd_DOWN;
	GPIO_InitStructure.GPIO_Pin = GPIO_Pin_4;
	GPIO_Init(GPIOA, &GPIO_InitStructure);

	/* Connect EXTI Lines to Encoder GPIO Pins */
	SYSCFG_EXTILineConfig(EXTI_PortSourceGPIOB, EXTI_PinSource3);	//enc A output
	SYSCFG_EXTILineConfig(EXTI_PortSourceGPIOA, EXTI_PinSource15);	//enc B output
	SYSCFG_EXTILineConfig(EXTI_PortSourceGPIOB, EXTI_PinSource4);	//enc button

	/* Configure encoder EXTI line */
	EXTI_InitStructure.EXTI_Line = EXTI_Line3;
	EXTI_InitStructure.EXTI_Mode = EXTI_Mode_Interrupt;
	EXTI_InitStructure.EXTI_Trigger = EXTI_Trigger_Rising_Falling;  
	EXTI_InitStructure.EXTI_LineCmd = ENABLE;
	EXTI_Init(&EXTI_InitStructure);

	EXTI_InitStructure.EXTI_Line = EXTI_Line15;
	EXTI_Init(&EXTI_InitStructure);

	/* Configure encoder EXTI switch line */
	EXTI_InitStructure.EXTI_Line = EXTI_Line4;
	EXTI_InitStructure.EXTI_Trigger = EXTI_Trigger_Rising;  
	EXTI_Init(&EXTI_InitStructure);

	/* Enable and set Encoder EXTI Interrupt to the lowest priority */
	NVIC_InitStructure.NVIC_IRQChannel = EXTI2_3_IRQn;
	NVIC_InitStructure.NVIC_IRQChannelPriority = 0x03;
	NVIC_InitStructure.NVIC_IRQChannelCmd = ENABLE;
	NVIC_Init(&NVIC_InitStructure); 

	/* Enable and set Buttons EXTI Interrupt to the lowest priority */
	NVIC_InitStructure.NVIC_IRQChannel = EXTI4_15_IRQn;
	NVIC_InitStructure.NVIC_IRQChannelPriority = 0x03;
	NVIC_InitStructure.NVIC_IRQChannelCmd = ENABLE;
	NVIC_Init(&NVIC_InitStructure); 

	/* Init displays */
	i2c_send_session(session_expander_config,GPIO_EXPANDER_0_ADDRESS);
	i2c_send_session(session_expander_config,GPIO_EXPANDER_1_ADDRESS);

	/* Init tcn75 temp sensor */
	i2c_send_session(session_config_tcn75_temp,TEMP_TCN75A_ADDRESS);
}

void init_ADC(void)
{
	ADC_InitTypeDef     ADC_InitStructure;
	TIM_TimeBaseInitTypeDef  TIM_TimeBaseStructure;
	DMA_InitTypeDef     DMA_InitStructure;

	/* Periph clock	enable *******************************************************/
	RCC_APB2PeriphClockCmd(RCC_APB2Periph_TIM15, ENABLE);
	RCC_APB2PeriphClockCmd(RCC_APB2Periph_ADC1, ENABLE);
	RCC_AHBPeriphClockCmd(RCC_AHBPeriph_DMA1 , ENABLE);

	/* TIM15 Configuration *******************************************************/
	TIM_DeInit(TIM15);
	TIM_TimeBaseStructInit(&TIM_TimeBaseStructure);
	 
	/* Time base configuration */
	TIM_TimeBaseStructure.TIM_Period = 10;
	TIM_TimeBaseStructure.TIM_Prescaler = SystemCoreClock/1000;
	TIM_TimeBaseStructure.TIM_ClockDivision = 0x0;
	TIM_TimeBaseStructure.TIM_CounterMode = TIM_CounterMode_Up;  
	TIM_TimeBaseInit(TIM15, &TIM_TimeBaseStructure);

	/* TIM15 TRGO selection */
	TIM_SelectOutputTrigger(TIM15, TIM_TRGOSource_Update);


	/* DMA1 Configuration *******************************************************/
	/* DMA1 Channel1 Config */
	DMA_DeInit(DMA1_Channel1);
	DMA_InitStructure.DMA_PeripheralBaseAddr = (uint32_t)ADC1_DR_Address;
	DMA_InitStructure.DMA_MemoryBaseAddr = (uint32_t)ADC_Output;
	DMA_InitStructure.DMA_DIR = DMA_DIR_PeripheralSRC;
	DMA_InitStructure.DMA_BufferSize = 2;
	DMA_InitStructure.DMA_PeripheralInc = DMA_PeripheralInc_Disable;
	DMA_InitStructure.DMA_MemoryInc = DMA_MemoryInc_Enable;
	DMA_InitStructure.DMA_PeripheralDataSize = DMA_PeripheralDataSize_HalfWord;
	DMA_InitStructure.DMA_MemoryDataSize = DMA_MemoryDataSize_HalfWord;
	DMA_InitStructure.DMA_Mode = DMA_Mode_Circular;
	DMA_InitStructure.DMA_Priority = DMA_Priority_Medium;
	DMA_InitStructure.DMA_M2M = DMA_M2M_Disable;
	DMA_Init(DMA1_Channel1, &DMA_InitStructure);


	/* ADC1 Configuration *******************************************************/
	/* ADC1 DeInit */  
	ADC_DeInit(ADC1);

	/* ADC DMA request in circular mode */
	ADC_DMARequestModeConfig(ADC1, ADC_DMAMode_Circular);

	/* Initialize ADC structure */
	ADC_StructInit(&ADC_InitStructure);

	 /* Configure the ADC1 in continous mode withe a resolutuion equal to 12 bits*/
	ADC_InitStructure.ADC_Resolution = ADC_Resolution_12b;
	ADC_InitStructure.ADC_ContinuousConvMode = DISABLE;
	ADC_InitStructure.ADC_ExternalTrigConvEdge = ADC_ExternalTrigConvEdge_Rising;    
	ADC_InitStructure.ADC_ExternalTrigConv = ADC_ExternalTrigConv_T15_TRGO;
	ADC_InitStructure.ADC_DataAlign = ADC_DataAlign_Right;
	ADC_InitStructure.ADC_ScanDirection = ADC_ScanDirection_Upward;
	ADC_Init(ADC1, &ADC_InitStructure); 

	ADC_ChannelConfig(ADC1, ADC_Channel_TempSensor , ADC_SampleTime_239_5Cycles);  
	ADC_ChannelConfig(ADC1, ADC_Channel_Vrefint , ADC_SampleTime_239_5Cycles);

	/* Enable internal sensors */
	ADC_TempSensorCmd(ENABLE);
	ADC_VrefintCmd(ENABLE);
	//ADC_VbatCmd(ENABLE);

	/* ADC Calibration */
	ADC_GetCalibrationFactor(ADC1);

	/* Enable the auto delay feature */    
	ADC_WaitModeCmd(ADC1, ENABLE); 

/*=================== STARTING ========================*/

	/* Enable ADCperipheral */
	ADC_Cmd(ADC1, ENABLE);     
	/* Wait the ADEN flag */
	while(!ADC_GetFlagStatus(ADC1, ADC_FLAG_ADEN)); 

	/* Enable ADC_DMA */
	ADC_DMACmd(ADC1, ENABLE);
	/* TIM15 enable counter */
	TIM_Cmd(TIM15, ENABLE);

	/* ADC1 regular Software Start Conv */ 
	ADC_StartOfConversion(ADC1);

	/* DMA1 Channel1 enable */
	DMA_Cmd(DMA1_Channel1, ENABLE);
}

void init_USART(void)
{
	GPIO_InitTypeDef GPIO_InitStructure;
	USART_InitTypeDef USART_InitStructure;
	NVIC_InitTypeDef NVIC_InitStructure_USART1;

	/* Enable clocks */
	RCC_APB2PeriphClockCmd(RCC_APB2Periph_SYSCFG, ENABLE);
	RCC_AHBPeriphClockCmd(RCC_AHBPeriph_GPIOA, ENABLE);
	RCC_APB2PeriphClockCmd(RCC_APB2Periph_USART1, ENABLE);

	/* GPIO configuration */
	GPIO_InitStructure.GPIO_Pin =  GPIO_Pin_9 | GPIO_Pin_10;
	GPIO_InitStructure.GPIO_Speed = GPIO_Speed_50MHz;
	GPIO_InitStructure.GPIO_Mode = GPIO_Mode_AF;
	GPIO_InitStructure.GPIO_OType = GPIO_OType_PP;
	GPIO_InitStructure.GPIO_PuPd = GPIO_PuPd_UP;
	GPIO_Init(GPIOA, &GPIO_InitStructure);

	GPIO_PinAFConfig(GPIOA, GPIO_PinSource9, GPIO_AF_1);
	GPIO_PinAFConfig(GPIOA, GPIO_PinSource10, GPIO_AF_1);

	/* USART configuration */
	USART_InitStructure.USART_BaudRate = 115200;
	USART_InitStructure.USART_WordLength = USART_WordLength_8b;
	USART_InitStructure.USART_StopBits = USART_StopBits_1;
	USART_InitStructure.USART_Parity = USART_Parity_No;
	USART_InitStructure.USART_HardwareFlowControl = USART_HardwareFlowControl_None;
	USART_InitStructure.USART_Mode = USART_Mode_Rx | USART_Mode_Tx;
	USART_Init(USART1, &USART_InitStructure);

	USART_ITConfig(USART1, USART_IT_RXNE, ENABLE);

	/* Enable the USART1 Interrupts */
	NVIC_InitStructure_USART1.NVIC_IRQChannel = USART1_IRQn;
	NVIC_InitStructure_USART1.NVIC_IRQChannelPriority = 1;
	NVIC_InitStructure_USART1.NVIC_IRQChannelCmd = ENABLE;
	NVIC_Init(&NVIC_InitStructure_USART1);

	/* Enable USART1 */
	USART_Cmd(USART1, ENABLE);
}
void init_Triacs(void)
{
	TIM_TimeBaseInitTypeDef  TIM_TimeBaseStructure;
	TIM_OCInitTypeDef  TIM_OCInitStructure;
	GPIO_InitTypeDef GPIO_InitStructure;

	/* Clocks enable */
	RCC_APB1PeriphClockCmd(RCC_APB1Periph_TIM3, ENABLE);
	RCC_AHBPeriphClockCmd(RCC_AHBPeriph_GPIOA | RCC_AHBPeriph_GPIOB, ENABLE);

	/* GPIOA Configuration: TIM3 CH1 (PA6) and TIM3 CH2 (PA7) */
	GPIO_InitStructure.GPIO_Pin = GPIO_Pin_6 | GPIO_Pin_7;
	GPIO_InitStructure.GPIO_Mode = GPIO_Mode_AF;
	GPIO_InitStructure.GPIO_Speed = GPIO_Speed_50MHz;
	GPIO_InitStructure.GPIO_OType = GPIO_OType_PP;
	GPIO_InitStructure.GPIO_PuPd = GPIO_PuPd_UP;
	GPIO_Init(GPIOA, &GPIO_InitStructure); 

	/* GPIOB Configuration: TIM3 CH3 (PB0) and TIM3 CH4 (PB1) */
	GPIO_InitStructure.GPIO_Pin = GPIO_Pin_0 | GPIO_Pin_1;
	GPIO_Init(GPIOB, &GPIO_InitStructure);

	GPIO_PinAFConfig(GPIOA, GPIO_PinSource6, GPIO_AF_1);
	GPIO_PinAFConfig(GPIOA, GPIO_PinSource7, GPIO_AF_1); 
	GPIO_PinAFConfig(GPIOB, GPIO_PinSource0, GPIO_AF_1);
	GPIO_PinAFConfig(GPIOB, GPIO_PinSource1, GPIO_AF_1);

	/* Init Timer init structures */
	TIM_TimeBaseStructInit(&TIM_TimeBaseStructure);
	TIM_OCStructInit(&TIM_OCInitStructure);

	/* Time base configuration */
	TIM_TimeBaseStructure.TIM_Period = 1000-1;
	TIM_TimeBaseStructure.TIM_Prescaler = (uint16_t) (SystemCoreClock / 10000) - 1;
	TIM_TimeBaseStructure.TIM_ClockDivision = 0;
	TIM_TimeBaseStructure.TIM_CounterMode = TIM_CounterMode_Up;
	TIM_TimeBaseInit(TIM3, &TIM_TimeBaseStructure);

	/* Output Compare Active Mode configuration: Channel1 */
	TIM_OCInitStructure.TIM_OCMode = TIM_OCMode_PWM1;
	TIM_OCInitStructure.TIM_OutputState = TIM_OutputState_Enable;
	TIM_OCInitStructure.TIM_OCPolarity = TIM_OCPolarity_High;
	
	TIM_OCInitStructure.TIM_Pulse = 0;
	TIM_OC1Init(TIM3, &TIM_OCInitStructure);
	TIM_OC2Init(TIM3, &TIM_OCInitStructure);
	TIM_OC3Init(TIM3, &TIM_OCInitStructure);
	TIM_OC4Init(TIM3, &TIM_OCInitStructure);

	/* TIM3 enable counter */
	TIM_Cmd(TIM3, ENABLE);
}
