kumencz/ROwen/FW/Source/ROwen/time.c

/* Includes ------------------------------------------------------------------*/
#include "main.h"

/* Private typedef -----------------------------------------------------------*/

/* Private define ------------------------------------------------------------*/
/* Private macro -------------------------------------------------------------*/
/* Private variables ---------------------------------------------------------*/
/* Private function prototypes -----------------------------------------------*/
/* Private functions ---------------------------------------------------------*/
/* Private macro -------------------------------------------------------------*/
/* Private variables ---------------------------------------------------------*/
uint32_t real_time = 0;		//presnost = 0.1s
bool up = true;
uint8_t TIM_10MS_COUNTER;
uint16_t TIM_100MS_COUNTER;
uint16_t TIM_1000MS_COUNTER;

uint8_t TIM_1MS_FLAG;
uint8_t TIM_10MS_FLAG;
uint8_t TIM_100MS_FLAG;
uint8_t TIM_1000MS_FLAG;

uint8_t test_counter = 0;
uint32_t speed_counter = 0;
uint32_t speed = 0;
static volatile uint32_t TimingDelay;
inline void Delay(__IO uint32_t nTime)
{ 
  TimingDelay = nTime;
  while(TimingDelay != 0);
}

inline void Delay_tick(__IO uint32_t nCount)
{
	while(nCount--);
}
inline void TimingDelay_Decrement(void)
{
  if (TimingDelay != 0x00)
    TimingDelay--;
}

void Period_timer_increment(void) //called each 1ms
{
		TimingDelay_Decrement();
		TIM_1MS_FLAG = 1;
		TIM_10MS_COUNTER++;	
	if (TIM_10MS_COUNTER >= 10)
	{
		TIM_10MS_COUNTER = 0;
		TIM_10MS_FLAG = 1;
		TIM_100MS_COUNTER += 10;
	}				
	if (TIM_100MS_COUNTER >= 100)
	{
		TIM_100MS_COUNTER = 0;
		TIM_100MS_FLAG = 1;
		TIM_1000MS_COUNTER += 100;
	}		
	if (TIM_1000MS_COUNTER >= 1000)
	{
		TIM_1000MS_COUNTER = 0;
		TIM_1000MS_FLAG = 1;
	}
}

void period_time_check_flags(void)
{
	if (TIM_1MS_FLAG)
	{
		tim_1ms_loop();
		TIM_1MS_FLAG = 0;
	}
	if (TIM_10MS_FLAG)
	{
		tim_10ms_loop();
		TIM_10MS_FLAG = 0;
	}
	if (TIM_100MS_FLAG)
	{
		tim_100ms_loop();
		TIM_100MS_FLAG = 0;
	}
	if (TIM_1000MS_FLAG)
	{
		tim_1000ms_loop();
		TIM_1000MS_FLAG = 0;
	}
}

void tim_1ms_loop(void)
{
	for(int i = 0; i <= 4; i++)
	{
		if(buttons_delay[i] > 0)
			buttons_delay[i]--;
	}
	
	if(buzzer_mode == strobo || buzzer_mode == beeps)
	{
		if(buzzer_beep_time_counter++ >= buzzer_beep_time)
		{
			buzzer_beep_time_counter = 0;
			
			
			if(buzzer_mode == strobo)
			{
				if(buzzer_beeps_counter)
				{
					GPIO_ResetBits(GPIOB, GPIO_Pin_15);
					buzzer_beeps_counter--;
				}else
				{
					GPIO_SetBits(GPIOB, GPIO_Pin_15);
					buzzer_beeps_counter++;
				}
			}else if(buzzer_mode == beeps && buzzer_beeps_counter)
			{
				if(buzzer_beeps_counter%2 == 0)
				{
					GPIO_ResetBits(GPIOB, GPIO_Pin_15);
				}
				else
				{
					GPIO_SetBits(GPIOB, GPIO_Pin_15);
				}
				buzzer_beeps_counter--;
			}
		}
	}
	if(display_block != 0)
		display_block--;

	if(curr_ramp.running)
	{
		if(++curr_ramp.time_in_step >= curr_ramp.current_ramp[curr_ramp.current_step].duration*1000)
		{
			curr_ramp.time_in_step = 0;
			if(++curr_ramp.current_step >= 10)
			{
				curr_ramp.running = false;
				triac_set_duty(triac_3,0); //light off
				text_to_display("end");
			}
		}
	}
	i2c_process_session();
}
void tim_10ms_loop(void)
{

}

void tim_100ms_loop(void)
{ 
	real_time++;
	i2c_send_session(session_get_ext_ADC_voltages,ADC_EXT_ADDRESS);
	ADC_read();
	i2c_send_session(session_get_tcn75_temp,TEMP_TCN75A_ADDRESS); //get temp from TCN75A
	if(mode_current == 3 || mode_current == 9 || mode_current == 14 || mode_current == 15 || mode_current == 16 || curr_ramp.running)
		number_to_display((s_system.s_temp.thermocouple[2] > s_system.s_temp.thermocouple[3]) ? s_system.s_temp.thermocouple[3] : s_system.s_temp.thermocouple[2], 0);
//	if(up)
//	{
//		if(++s_system.s_temp.thermocouple[2] > 300 )
//			up = false;
//	}
//	else
//	{
//		if(--s_system.s_temp.thermocouple[2] < 25 )
//			up = true;
//	}
	/* running LED blink */
	GPIOB->ODR ^= GPIO_Pin_6;
}

void tim_1000ms_loop(void)
{
	if(curr_ramp.running)
	{
		PID_update_temp(ramp_get_temp(&curr_ramp));
	}else if(set_temp_mem > 0)
	{
		PID_update_temp(set_temp_mem);
	}
	uart_send_temps();
	/* SPEED meter */
	speed = speed_counter;
	speed_counter = 0;
}
