kumencz/ROwen/(commit log)

2015-03-30 Initial PCB design
    [ROwen_Power.brd, ROwen_Power.sch, ROwen_main.brd, ROwen_main.sch, ROwen_thermocouple.brd, ROwen_thermocouple.sch]
2015-03-31 small PCB updates
    [ROwen_main.brd, ROwen_main.sch]
2015-04-10 Polygon improvement
    [ROwen_Power.brd, ROwen_Power.sch, ROwen_main.brd, ROwen_main.sch]
2015-04-10 Polygon improvement 2
    [ROwen_thermocouple.brd]
2015-04-14 Manufactured version
    [ROwen_main.brd, ROwen_main.sch, ROwen_thermocouple.brd, ROwen_thermocouple.sch]
2015-04-14 GND polygon separated
    [ROwen_main.brd]
2015-04-16 Main PCB measerements
    [ROwen_Power.brd, ROwen_main.brd]
2015-04-18 Added STM32CubeMX configuration for STM32F051
2015-04-29 Prepare for ADC
2015-05-02 LEDs, buttons, encoder, buzzer initialization and basic function
    [communication.h, comunication.c, control.c, control.h, hmi.c, hmi.h, init.c, init.h]
2015-05-02 Initial i2c support for "i2c expander", tcn75a temp, MCP344 ADC
2015-05-03 Init ADC, MCU voltage, MCU temp
2015-05-03 UART sending temps
2015-05-03 i2c sessions enumerated
2015-05-03 UART prepare for TX direction interrupt
2015-05-04 ADC measure, TRIAC TIM Init
2015-05-06 Display fix for zero number
    [hmi.c]
2015-05-06 Human readable UART output
2015-05-09 Underclock to 8MHz, Triac PWM on 1Hz
2015-05-10 Power PCB scheme cleared
    [ROwen_Power.sch]
2015-05-10 Uart receive prepare, Triacs PWM repair
2016-02-20 Encoder handling rewrited
    Code cleaning
2016-02-29 Reading all 4 channels from thermocouple ADC
2016-03-02 Controlling of top LEDs + project file changes
2016-04-24 Triacs power control only in 100 steps.
2016-04-24 HMI power control only in 100 steps + LED bargraph function.
2020-12-23 Added 3D printable case stl files
    [logic_board_case_rev1.stl, logic_board_case_top_rev1.stl]
2020-12-23 Added BOM and basic documentation
2020-12-23 Added old PCB renders
2020-12-23 Added STM32CubeIDE project files and GCC linker file
2020-12-23 PID, Profile ramps, Fan ... forgotten development commit
2020-12-23 Manual temperature set finished and working, other small improvements and fixes
    [control.c, control.h, hmi.c, time.c]
