kumencz/ROwen/(notices)

Notices in the files:
parts and their libraries:
Copyright (C) PaJa 2001-2011
Copyright (C) PaJa 2011
